coondog024/NascarApi/3d-prints/starlink-mini-can-am/stl/assembly_preview.stl

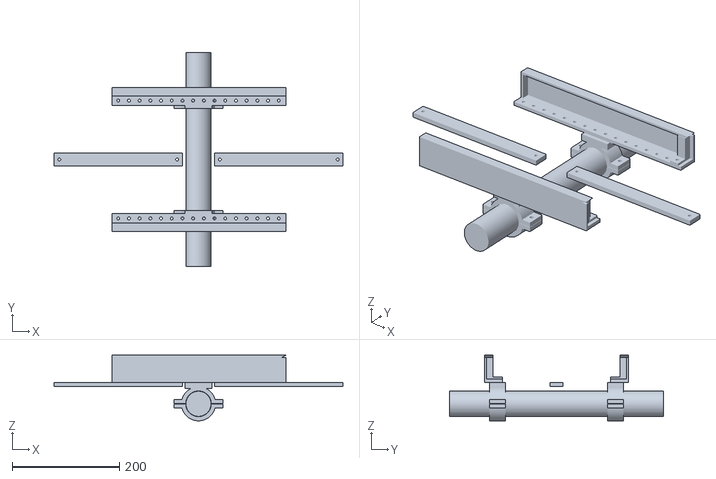
[picture p3: CAD file, 2026-10-20]
3d-prints/starlink-mini-can-am/stl/assembly_preview.stl
540.0 x 400.0 x 122.8
