coondog024/NascarApi/3d-prints/starlink-mini-can-am/stl/rail_front_R.stl

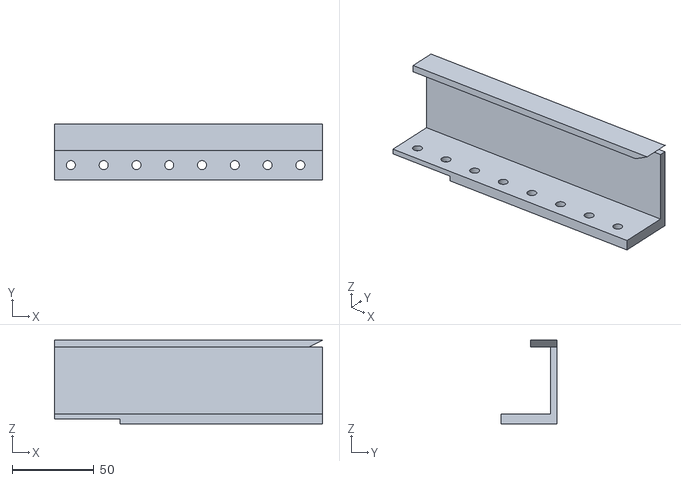
[picture p4: CAD file, 2026-10-20]
3d-prints/starlink-mini-can-am/stl/rail_front_R.stl
163.5 x 34.0 x 51.0
