coondog024/NascarApi/3d-prints/starlink-mini-can-am/stl/clamp_bottom_1.85in.stl

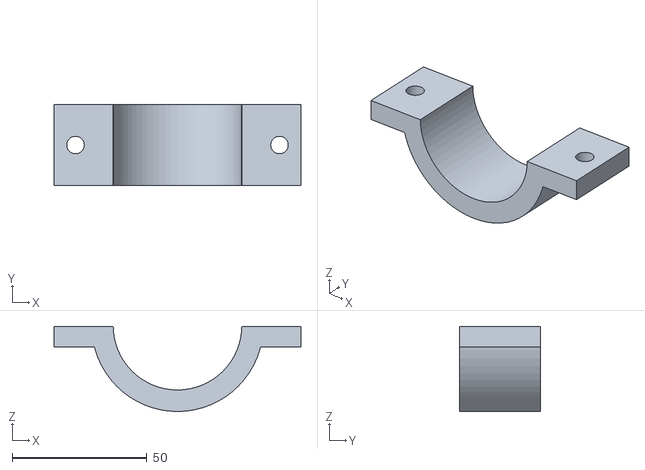
[picture p5: CAD file, 2026-10-20]
3d-prints/starlink-mini-can-am/stl/clamp_bottom_1.85in.stl
91.8 x 30.0 x 31.6
