coondog024/NascarApi/3d-prints/starlink-mini-can-am/stl/rail_rear_L.stl

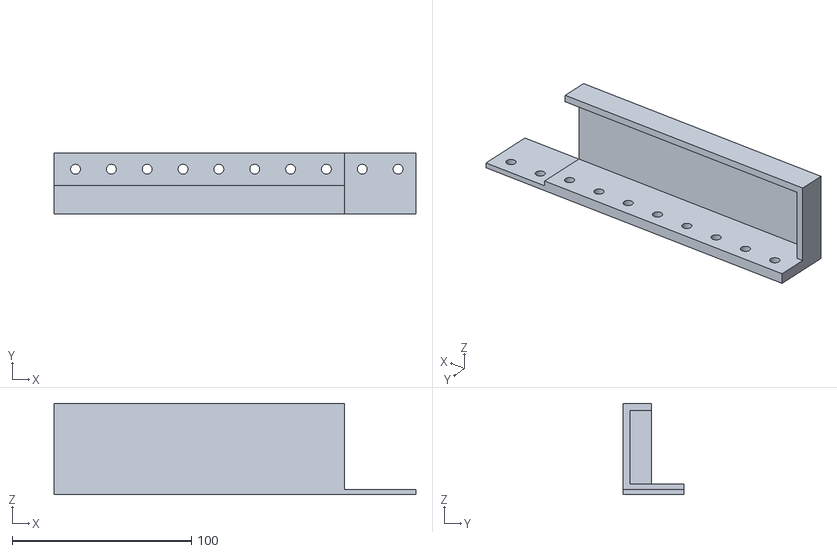
[picture p6: CAD file, 2026-10-20]
3d-prints/starlink-mini-can-am/stl/rail_rear_L.stl
202.0 x 34.0 x 51.0
