coondog024/NascarApi/3d-prints/starlink-mini-can-am/stl/crossbar.stl

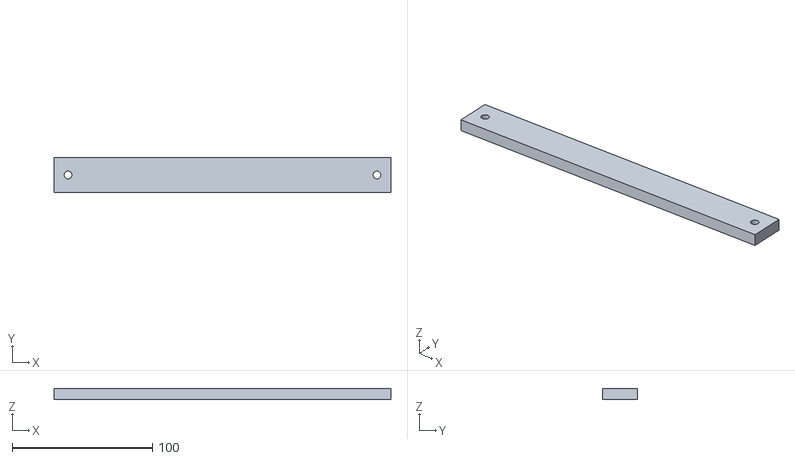
[picture p8: CAD file, 2026-10-20]
3d-prints/starlink-mini-can-am/stl/crossbar.stl
240.0 x 25.0 x 8.00
