coondog024/NascarApi/3d-prints/starlink-mini-can-am/stl/retainer_L.stl

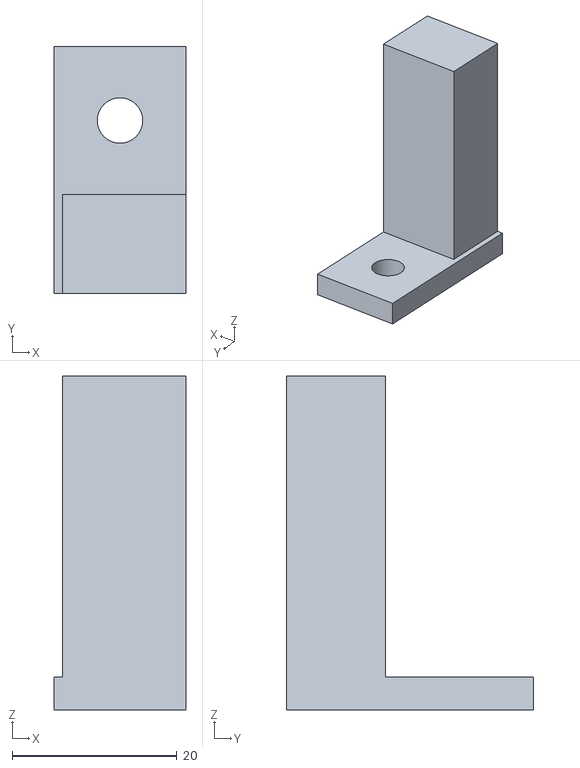
[picture p9: CAD file, 2026-10-20]
3d-prints/starlink-mini-can-am/stl/retainer_L.stl
16.0 x 30.0 x 40.5
