coondog024/NascarApi/3d-prints/starlink-mini-can-am/stl/clamp_bottom_1.75in.stl

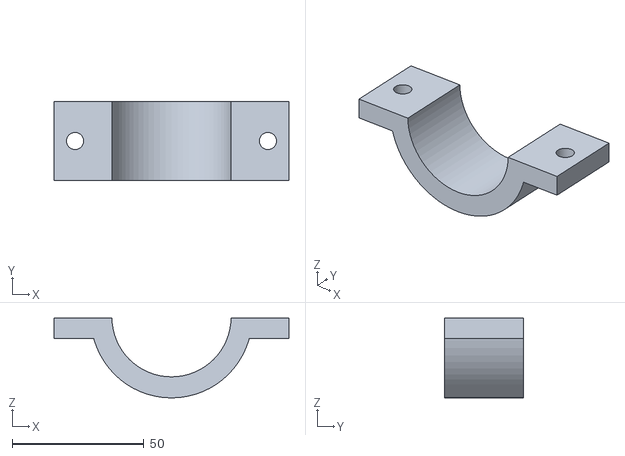
[picture p10: CAD file, 2026-10-20]
3d-prints/starlink-mini-can-am/stl/clamp_bottom_1.75in.stl
89.2 x 30.0 x 30.3
