coondog024/NascarApi/3d-prints/starlink-mini-can-am/stl/clamp_bottom_2.00in.stl

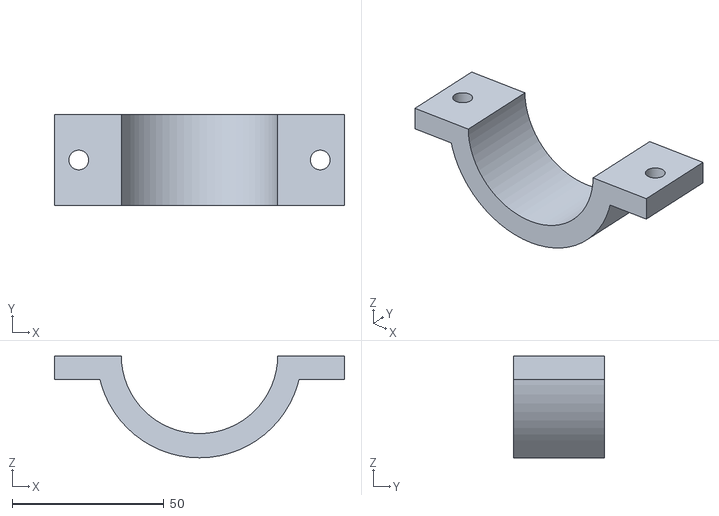
[picture p11: CAD file, 2026-10-20]
3d-prints/starlink-mini-can-am/stl/clamp_bottom_2.00in.stl
95.6 x 30.0 x 33.5
