coondog024/NascarApi/3d-prints/starlink-mini-can-am/stl/clamp_top_1.75in.stl

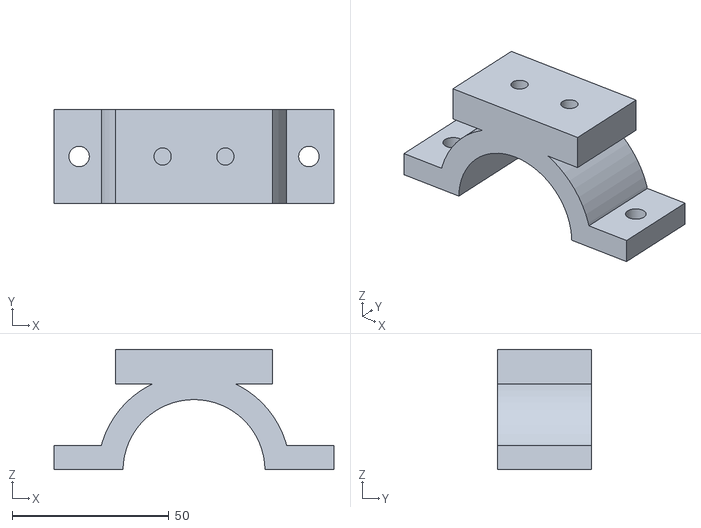
[picture p12: CAD file, 2026-10-20]
3d-prints/starlink-mini-can-am/stl/clamp_top_1.75in.stl
89.2 x 30.0 x 38.3
