coondog024/NascarApi/(list of files, cad)

Other CAD files:
3d-prints/starlink-mini-can-am/stl/rail_front_L.stl
3d-prints/starlink-mini-can-am/stl/rail_rear_R.stl
3d-prints/starlink-mini-can-am/stl/retainer_R.stl
