coondog024/NascarApi/3d-prints/starlink-mini-can-am/preview_end.png

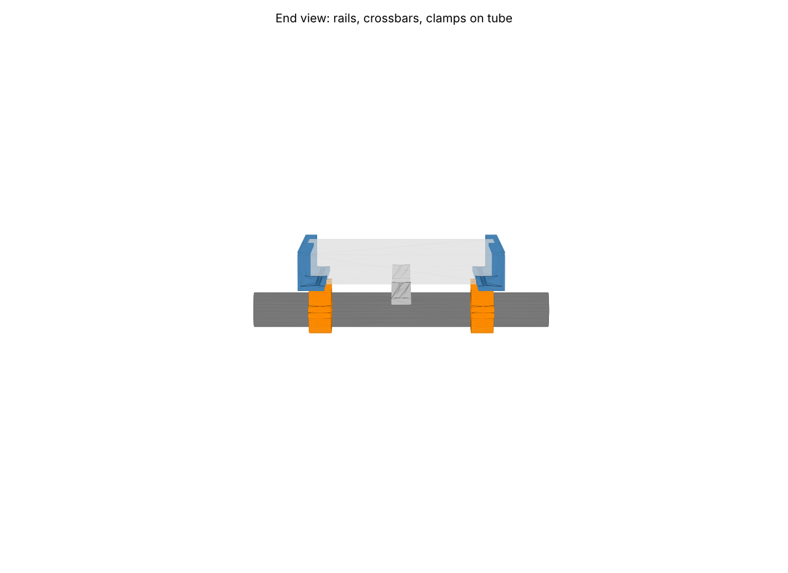
3d-prints/starlink-mini-can-am/preview_end.png
